samuelwilliams413/METR4901/Report/ReadMe.txt

A folder named \Build Photos is referenced in the report. It was too large for turn it in. The file can be found at https://drive.google.com/open?id=0B4WJuqQCXdjjd29NcDBHSWNPaW8

The file was also forwarded to my Supervisor Dr Paul Pounds
