samuelwilliams413/METR4901/Demo Poster/FUNC.pptx

Observe current state of pilot/desired state of suit

Measure position of limbs in relation to origin

Define Origin / Rotational Axis

Measure position of limbs in relation to fixed rotational axis on suit

Parse readings into useable data

Create fixed measurement point

Detect distance / proximity

Map from ADC readings to meters

Detect Signal

Remove Noise

Apply Sufficient Amplification

Read Signal

Determine action required

Derive required action of the suit from any given state

Develop control method based on kinematics of the suit

Tune PID Parameters

Derive Equations of Motion (EOM)

Derive Transfer function ( θ→τ )

Laplace Transform

Derive PID parameters

Achieve/approach the desired position of the suit

Observe and apply currently required change in commands

OUTSIDE OF SCOPE
Measure position of suit

OUTSIDE OF SCOPE
Regulate torque output of actuators

Observe current state of suit

Communicate Desired Action

Receive Messages

Transmit Messages

Read values into memory (DMA)

Parse Messages

Create Messages

Read values from memory (DMA)

Create Messaging Protocol

Establish DMA

Transmit Message over communications system

Measure suit interaction with environment (force)

Measure pilot interaction with suit (force)

Demonstrate functionality of subsystems

Demonstrate functionality of distance measurement (SS1)

Demonstrate functionality of force measurement (SS2)

Demonstrate functionality of control system (SS3)

Demonstrate functionality of communication (SS4)

Demonstrate force application trigger safety stop

Demonstrate system responding appropriately to stimulus

Demonstrate messages being transmitted over UART

Demonstrate system behaviour being adjusted via comms

Show actuator position adjusting due to distance measurement

Show sensor readings adjusting actuator over UART

Adjust actuator position in response to system command

Measure force applied at external contact points

Measure force applied at internal contact points

Parse readings into useable data

Create rigid contact points

Measure Force Applied

Create frame

Create Sensor Mount

Map from ADC readings to meters

Amplify Signal

Measure Force via Load Cell

SS1: Relative Position of Pilot

SS2: Force applied by & to Exoskeleton

SS3: Controls and Decision Making

SS4: Communications

Outside of Scope

SS5: Actuation Systems
