samuelwilliams413/METR4901/Demo Poster/Graphics.pptx

Pilot Foot

Maintain ∆F=0

Pilot Force

Suit Force

Ground

Forward Proximity

Pilot Thigh

x_(Forward)

x_(Rear)

Pilot Shin

Maintain
∆x=0
→∆θ=0

Rear Proximity
