samuelwilliams413/METR4901/Demo Poster/Signal_Data_Flow_Diagram.pptx

PXY = GPIO Port X Pin Y

Previous Controller

UART [Baud 9600]

UART [Baud 9600]

Next Controller

RX(PA3), TX(PA2)

UART [Baud 9600]

Messages [ASCII]

Messages [ASCII]

UART [Baud 9600]

RX(PA10), TX(PA9)

UART1

Messages [ASCII]

DMA

Control & Status

NUCLEO-F303K8 Controller Software

UART2

Memory

PA4..PA7

Proximity (P1..P4) 0-5V

LM358AD Op Amp x2

Signal (P1..P4) 0-5V

4x Vishay TRCT5000 IR Sensor

Messages [ASCII]

Proximity
(P1..P4)

Timer 3 Channel 1

50kHz

Load (Top, Bottom)

PA0, PA1

2x INA125PA
Instrumentation Amp

Load (T1..T4, B1..B4)

8x YZC-161B
50kg Load Cell

Control

PWM Interface

Digital Control

Voltage 50kHz

Servo

PB4

Load (Top, Bottom) 0-5V

Power 50kHz

Motor
