samuelwilliams413/METR4901/Demo Poster/Process Flow.pptx

Main

ADC A-F

Update Position & Load

Torque Data

Store Torque Messages

Start

Initialise

Delay to initialise values before movement

Transmit messages via DMA

UART Messages

Position
& Load Data

Store Angle Messages

t > 1000 ms

Yes

Calculate Control (Torque)

No
