samuelwilliams413/METR4901/Demo Poster/Text C2.docx

The process of developing the controls for the system was as follows: develop equations of motion (EOM) for the system, derive transfer functions (TF) from the EOM, perform Laplace transforms on the TF, and develop PID control for the system.

To begin the control theory the following assuming are foundational:

- Pilot is self-correcting and self-balancing;
- Pilot and suit are rigidly attached at the torso;
- Suit legs are capable of operating and moving independently;

Based on these assumptions it is possible to treat each leg as separate, and symmetrical but independent control problems. By adding the design constraint that all actuators and limbs shall lay on the same rotational axis, it is possible to treat each leg as a 3 DOF RR manipulator. The generalised equation relating the torque of the system it is resulting accelerations and velocities is given by kt:

τ=Mq+v+g

Where

- τ= vector of applied generalised forces
- M= manipulator mass matrix
- q= generalised accelerations of the system
- v= vector of centrifugal and coriolis forces
- g= vector of gravity forces

To find the PID control parameters for each joint

Develop Equations of Motion

The generalised equation relating the torque of the system it is resulting accelerations and velocities is given by kt:

τ=Mq+v+g

Where

M=m_1 J_(v1)^T J_(v1) +J_(ω1)^T I_1 J_(ω1) +m_2 J_(v2)^T J_(v2) +J_(ω2)^T I_2 J_(ω2) +m_3 J_(v3)^T J_(v3) +J_(ω3)^T I_3 J_(ω3)

J_(vi) = kt

J_(ωi) = kt

p_(c1,c2,c3) =[l_1 cos(θ_1 ), l_1 cos(θ_1 )+l_2 cos(θ_1 +θ_2 ), l_1 cos(θ_1 )+l_2 cos(θ_1 +θ_2 )+l_3 cos(θ_1 +θ_2 +θ_3 )l_1 sin(θ_1 ), l_1 sin(θ_1 )+l_2 sin(θ_1 +θ_2 ), l_1 sin(θ_1 )+l_2 sin(θ_1 +θ_2 )+l_3 sin(θ_1 +θ_2 +θ_3 )0, 0, 0]

v=Mq-1/2[q^T M_(q1) qq^T M_(q2) qq^T M_(q3) q]=[b_111 , b_122 , b_133 b_211 , b_222 , b_233 b_311 , b_322 , b_333 ][q_1^2 q_2^2 q_3^2 ]+[][, , ]

v(q,q)=C(q)[q^2 ]+B(q)[qq]

C(q)=[b_111 , b_122 b_211 , b_222 , ⋯, b_(1nn) ⋯, b_(2nn) ⋮, ⋮b_(n11) , b_(n22) , ⋮, ⋮⋯, b_(nnn) ]

B(q)=

Develop Transfer Function
