samuelwilliams413/METR4901/Matlab Docs/compile_all.docx

## Contents

function [H] = compile_all(DOF, A)

Degrees_Of_Freedom = DOF

Degree_To_Analyse = A

## Remember Everything Is In Radians

syms s

Transfer_Functions = collect(get_EOM(DOF),s)

H = get_TF(Transfer_Functions)

sys = H(A)

type = 'PID'

pidTuner(sys,type)

end

Published with MATLAB® R2017b (http://www.mathworks.com/products/matlab/)
