samuelwilliams413/METR4901/Demo Poster/ControlParameters.pptx

L_1

m_1

I_1

θ_1 ,θ_1 ,θ_1

l_1

θ_2 ,θ_2 ,θ_2

l_2

m_2

I_2

L_2

I_3

m_3

l_3

θ_3 ,θ_3 ,θ_3

L_3
