samuelwilliams413/METR4901/Documentation/Controls.pptx

Exoskeleton

R

R

R

R

R

R

Two 3 DOF
RRR Manipulators

## Slide 2

P1

L_1

θ_1

Thigh Link

θ_2

P2

L_2

Shin Link

Foot Link

L_3

θ_3

P3
