samuelwilliams413/METR4901/Documentation/_Hydra_Prime/MX Cube Config/NVIC Config A.PNG

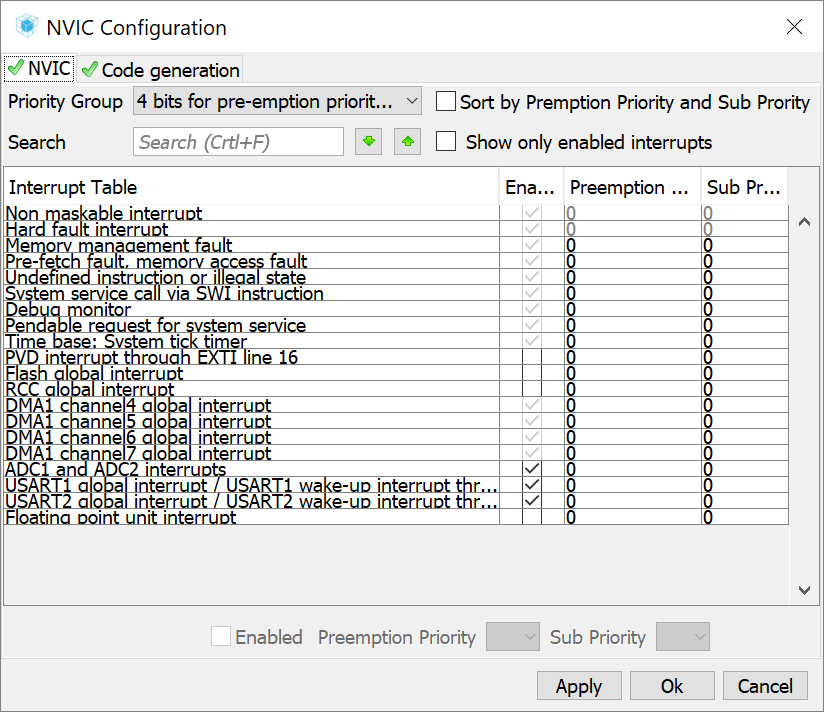
Documentation/_Hydra_Prime/MX Cube Config/NVIC Config A.PNG
