samuelwilliams413/METR4901/Documentation/_Hydra_Prime/MX Cube Config/Pin Outs.PNG

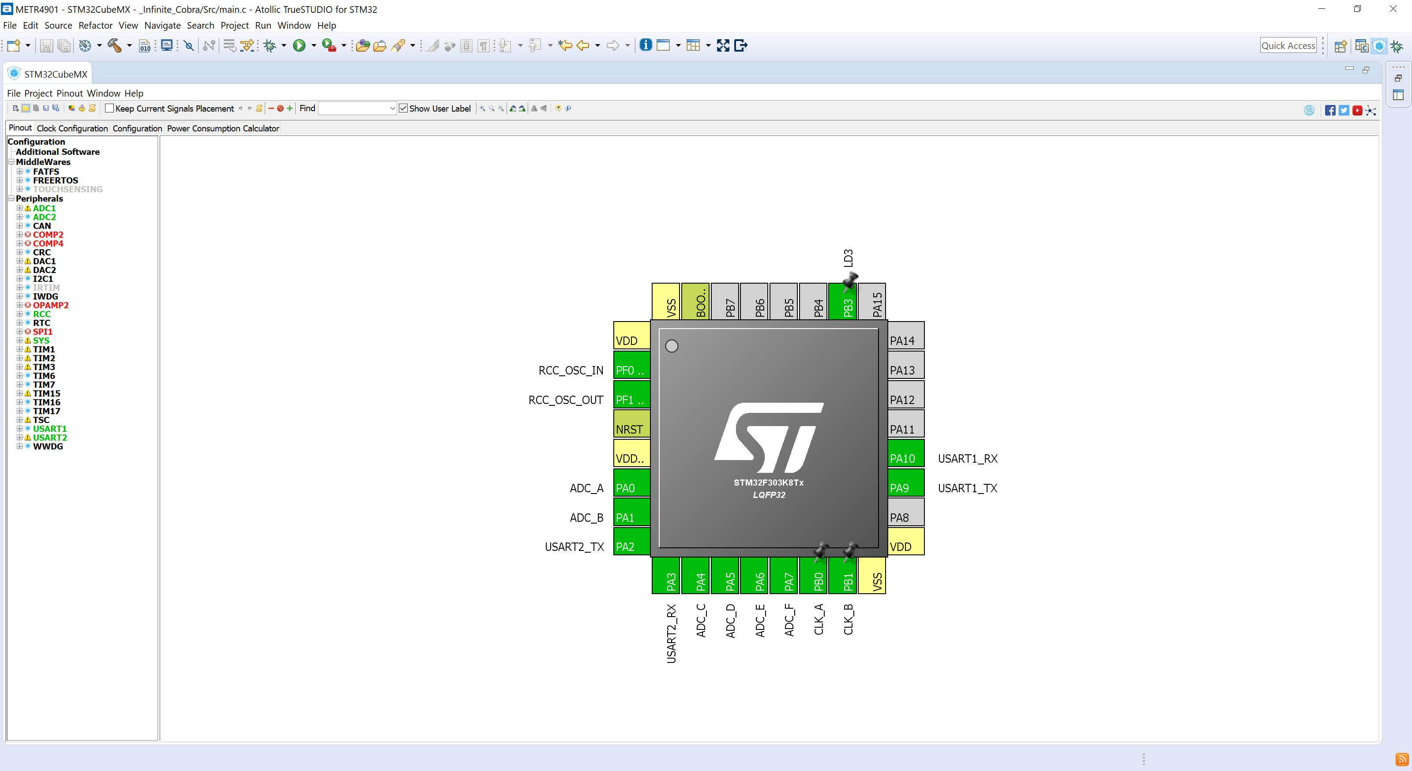
Documentation/_Hydra_Prime/MX Cube Config/Pin Outs.PNG
