samuelwilliams413/METR4901/Documentation/_Hydra_Prime/MX Cube Config/USART1 GPIO.PNG

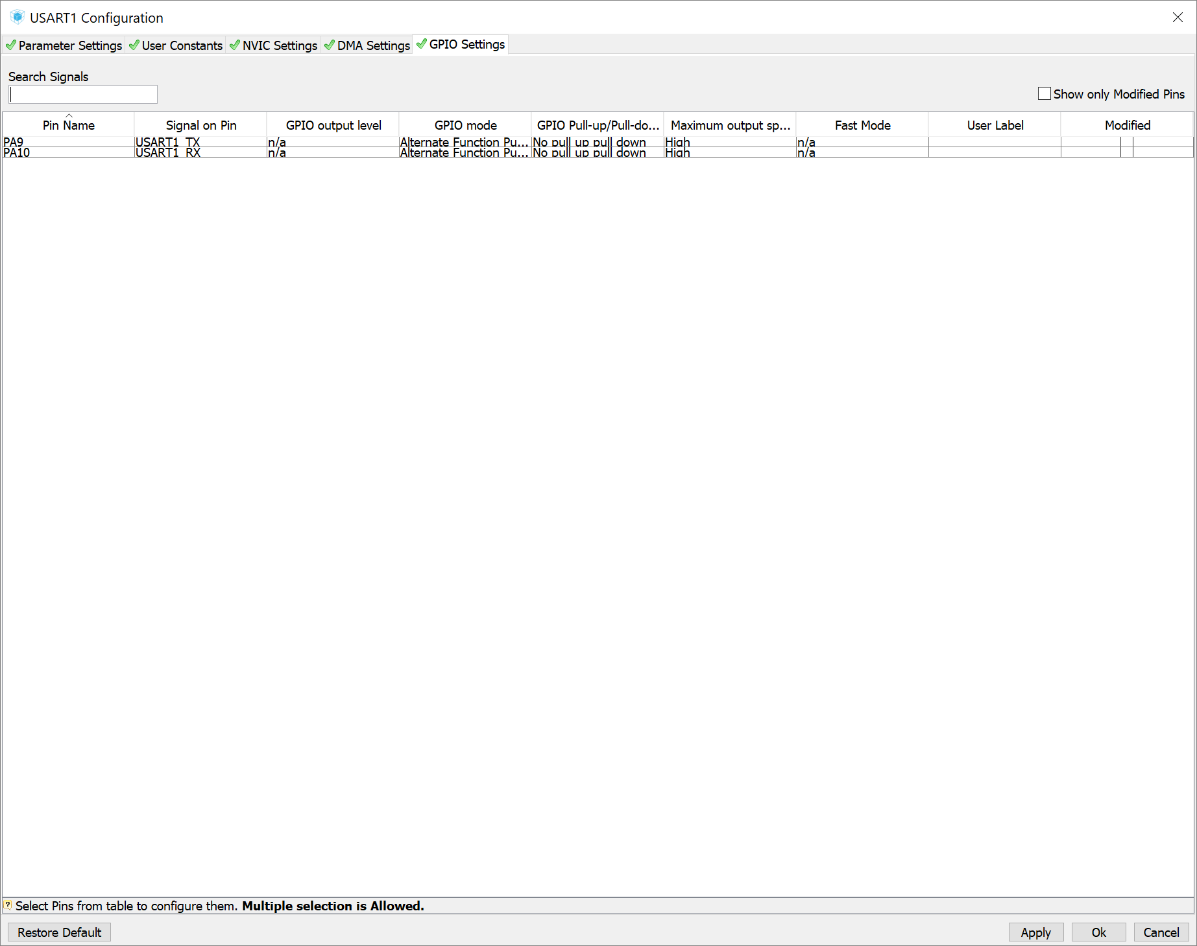
Documentation/_Hydra_Prime/MX Cube Config/USART1 GPIO.PNG
