samuelwilliams413/METR4901/Documentation/ADC Config.PNG

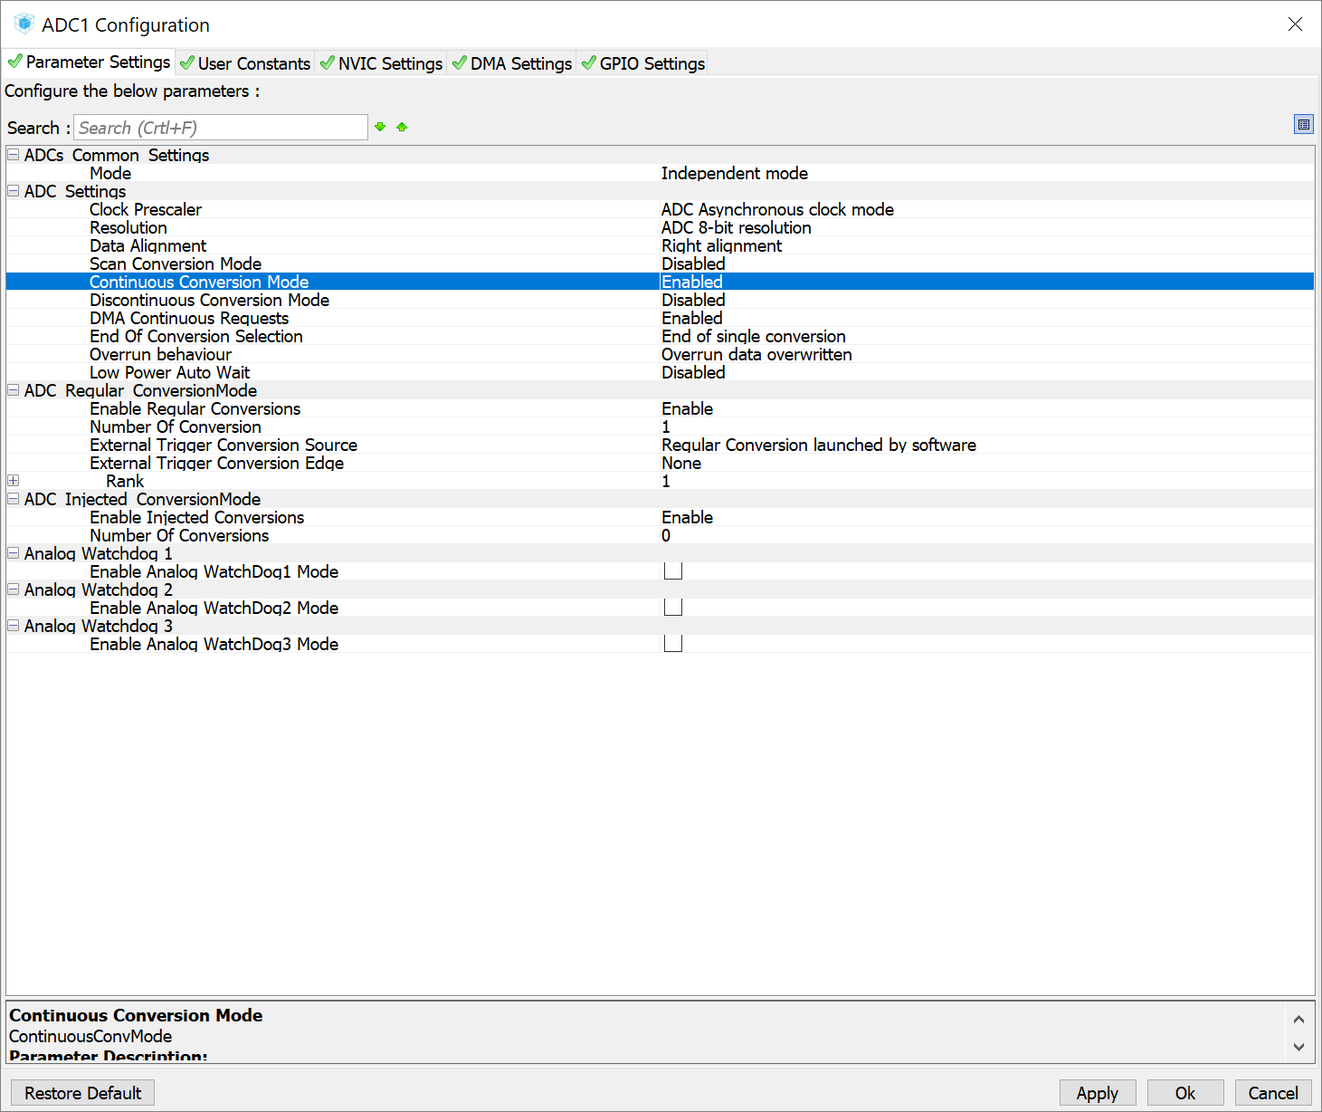
Documentation/ADC Config.PNG
