samuelwilliams413/METR4901/Documentation/ADC_2 Config part A.PNG

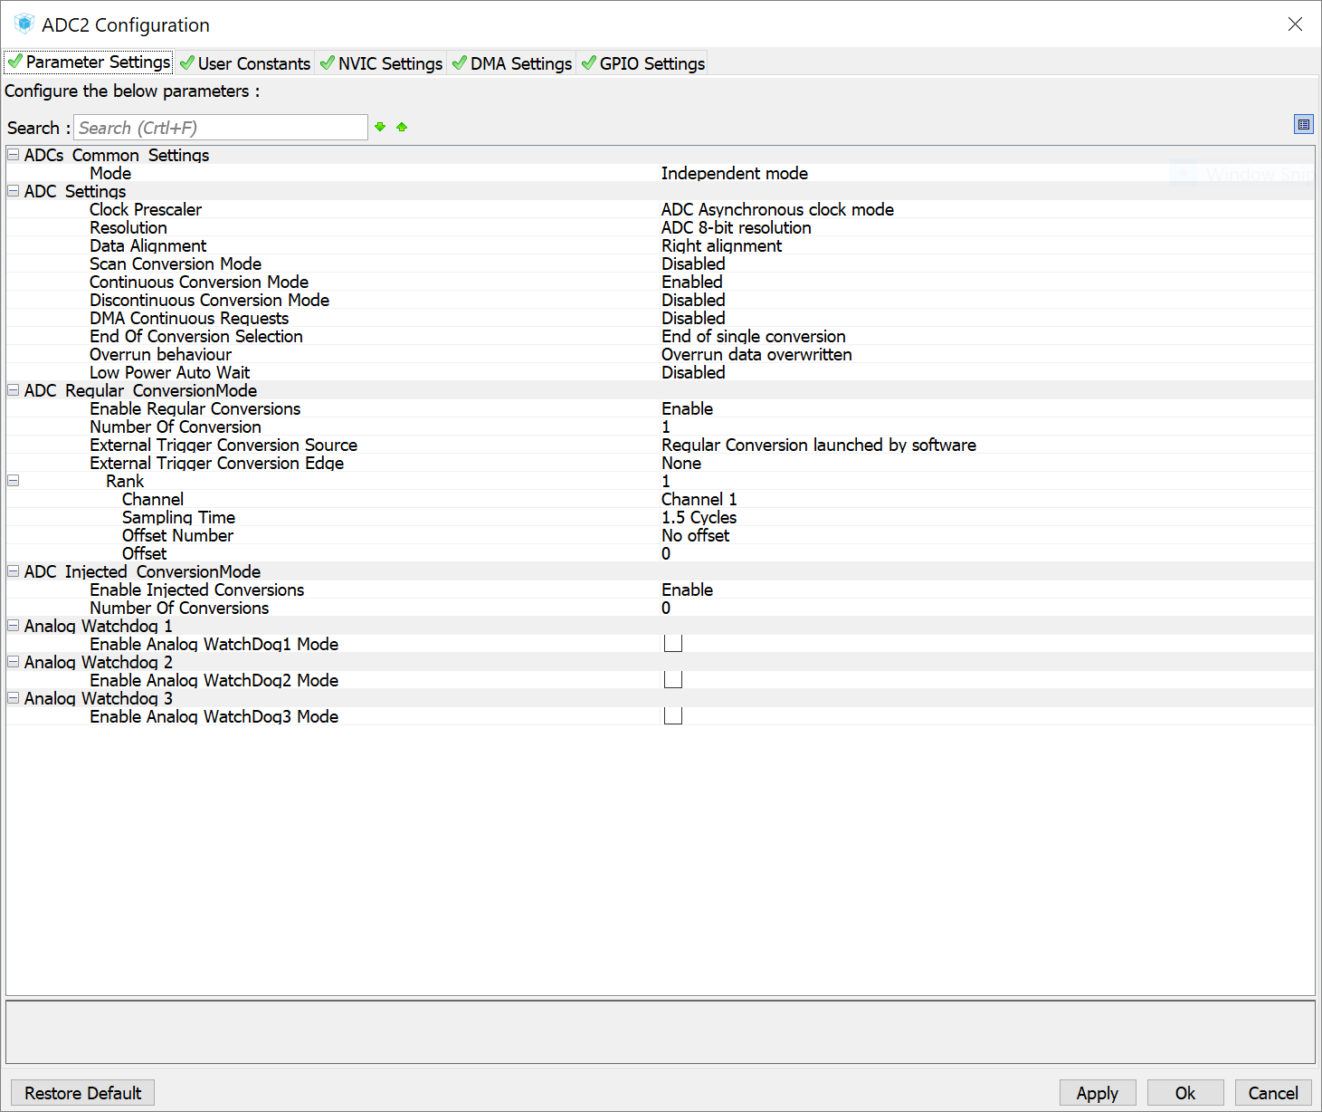
Documentation/ADC_2 Config part A.PNG
