samuelwilliams413/METR4901/Documentation/GPIO Pull down.PNG

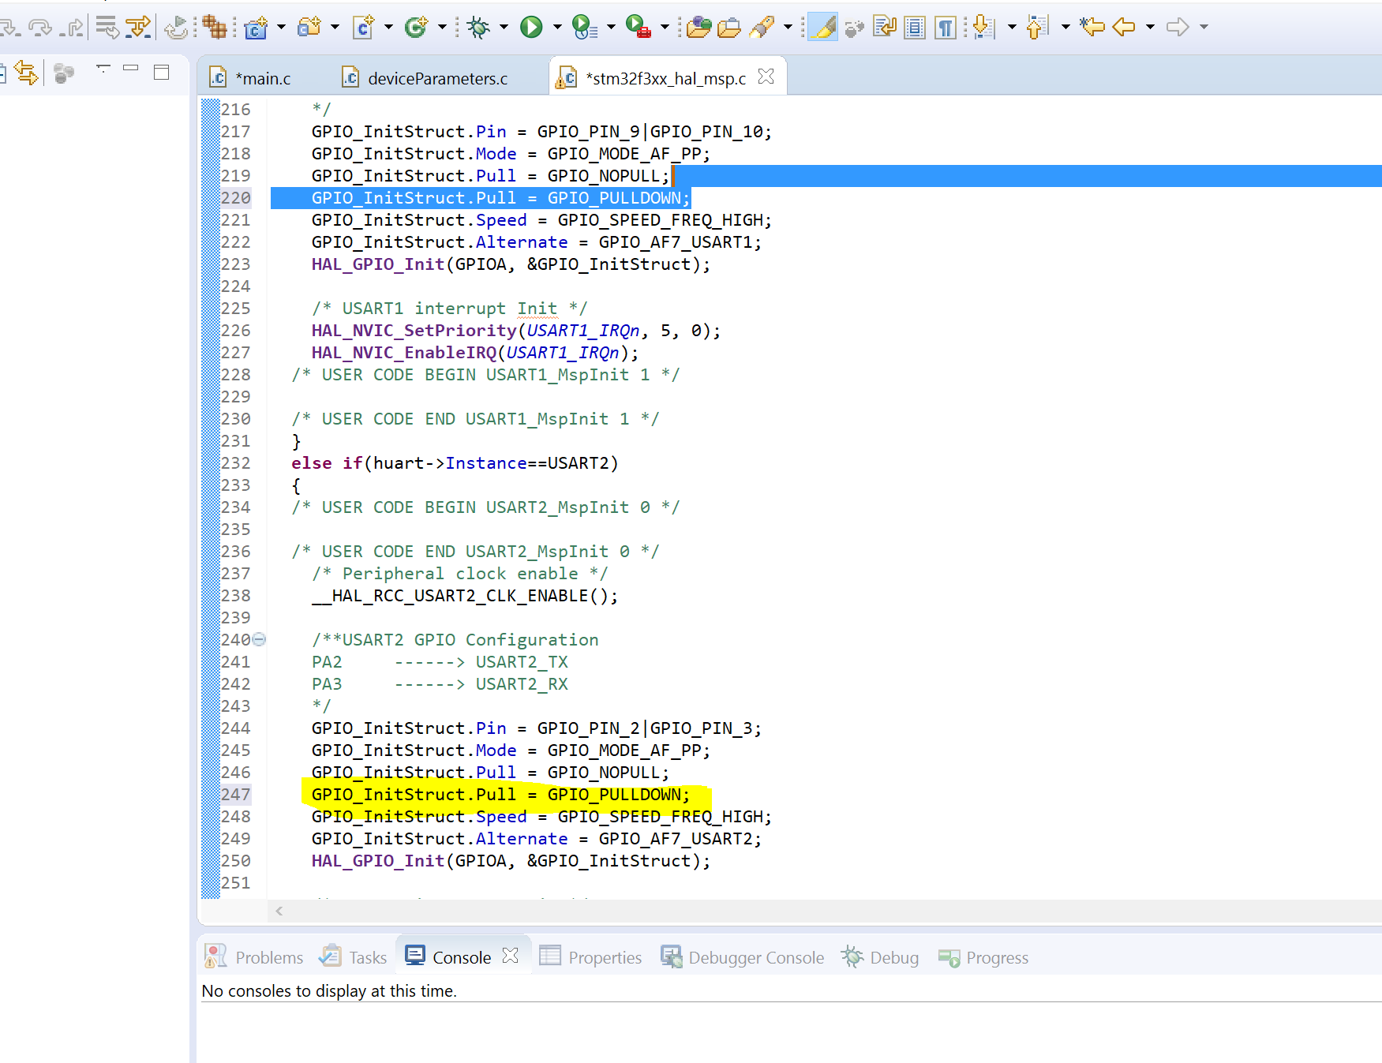
Documentation/GPIO Pull down.PNG
