samuelwilliams413/METR4901/Documentation/Putty Config.PNG

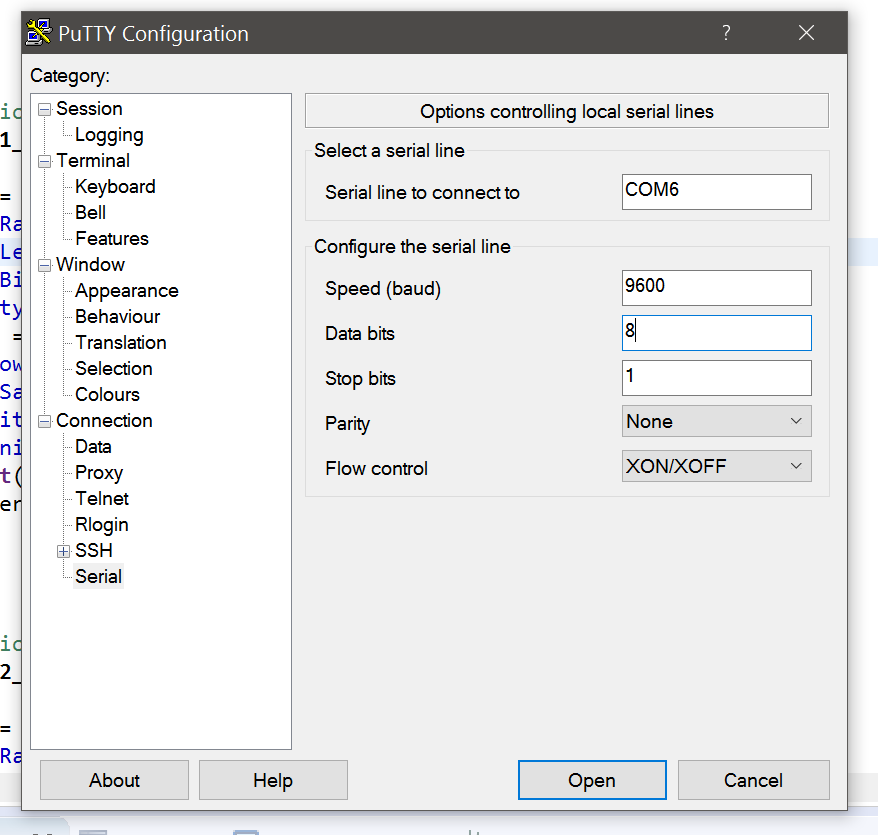
Documentation/Putty Config.PNG
