samuelwilliams413/METR4901/Documentation/UART1 Config.PNG

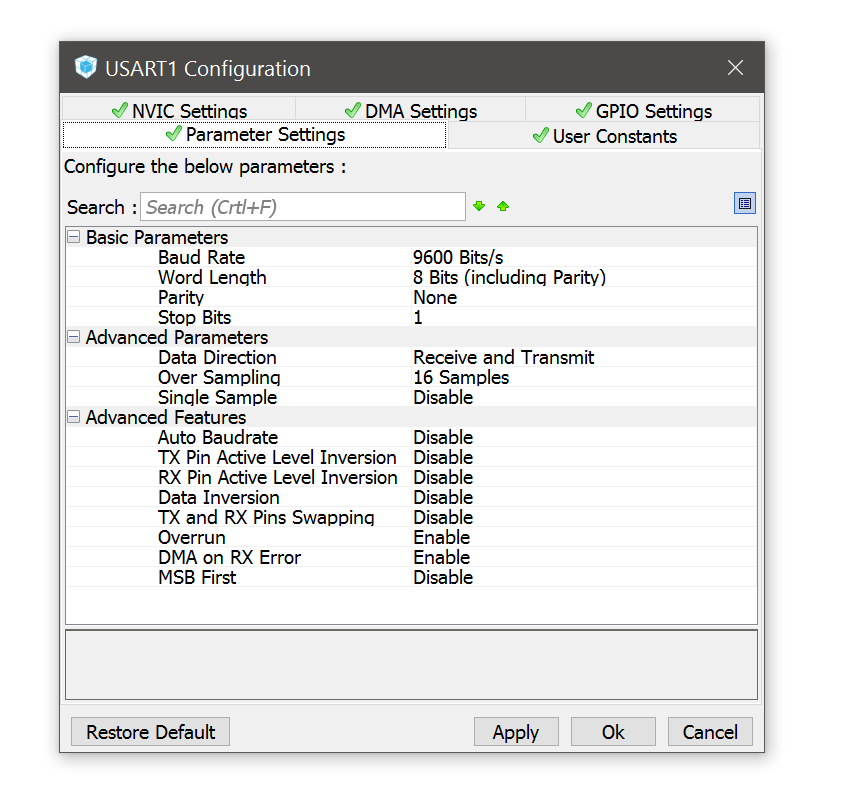
Documentation/UART1 Config.PNG
