samuelwilliams413/METR4901/BOM.xlsx

Sheet: BOM
BOM |  |  | TOTAL | 264.796 |  |  |  |  |  | Outstanding | 0 |  | 2018-04-20
Mount: | 7 |  |  |  |  |  |  |  |  |  |  |  | 7
Sensor: | 28 |  |  |  |  |  |  |  |  |  |  |  | 26
Part | QTY | Part Number | Cost | Total | Notes | RS Stock No. | Inventory | Safety | Picked | Remaining | Total | Remaining Inventory
Blue Led | 7 | Osram Opto CHIPLED 0603 470 nm Blue LED, 1608 (0603) SMD package | 0.404 | 2.828 | 10 Pack | 697-3617 | 3 |  | 7 | 0 | 0 | 0
Res 10k | 28 | Vishay CRCW Series Thick Film Surface Mount Fixed Resistor 0805 Case 10kΩ ±1% 0.125W ±100ppm/°C | 0.036 | 1.008 | 50 Pack | 679-0816 | 24 |  | 28 | 0 | 0 | 0
Res 220 | 28 | Vishay CRCW Series Thick Film Surface Mount Fixed Resistor 0805 Case 220Ω ±1% 0.125W ±100ppm/°C | 0.036 | 1.008 | 50 Pack | 679-1096 | 24 |  | 28 | 0 | 0 | 0
Res 1k | 7 | Vishay CRCW Series Thick Film Surface Mount Fixed Resistor 0805 Case 1kΩ ±1% 0.125W ±100ppm/°C | 0.036 | 0.252 | 50 Pack | 679-0982 | 43 |  | 7 | 0 | 0 | 36
Nucleo | 7 | STM32 Nucleo-32 development board | 16.73 | 117.11 | 0 | 0 | 1 |  | 7 | 0 | 0 | 0
Reflective IR Sensor | 28 | Vishay TCRT5000L, Through Hole Reflective Sensor, Transistor Output 2, Leaded package | 1.317 | 36.876 | 0 | 0 | 3 |  | 28 | 0 | 0 | 0
USB to Micro USB Cable (1.8m) | 7 | RS USB2.0 Cable, A-MicroB, M/M, 1.8m | 2.51 | 17.57 | 0 | 0 | 1 |  | 7 | 0 | 0 | 0
Ethernet Cable 1.5m | 7 | RJ45 YELLOW PATCH LEADS UTP | 2.83 | 19.81 | 0 | 0 | 1 |  | 7 | 0 | 0 | 0
PCB Header 36 Pin M | 0 | HARWIN M20, 2.54mm Pitch, 36 Way, 1 Row, Straight Pin Header, Through Hole | 1.32 | 0 | 0 | 547-3166 | 0 |  | 0 | 0 | 0 | 0
PCB Header 36 Pin M, Right Angle | 0 | HARWIN M20, 2.54mm Pitch, 36 Way, 1 Row, Right Angle Pin Header, Through Hole | 1.78 | 0 | 0 | 547-3217 | 0 |  | 0 | 0 | 0 | 0
PCB Header 45 Pin, Socket | 0 | Stelvio Kontek MODUCOM Series 2.54mm Pitch 45 Way 1 Row Straight PCB Socket, Through Hole, Solder Termination | 3.02 | 0 | 0 | 230-4893 | 0 |  | 0 | 0 | 0 | 0
Ethernet Header | 14 | RS Pro Cat5 8 Way Right Angle PCB Mount Unshielded RJ45 Connector Female | 1.8 | 25.2 | 0 | 8208299 | 2 |  | 14 | 0 | 0 | 0
Hose Clamp (16mm) | 0 | JCS Hi-Torque Steel Slotted Hex Hose Clip Bolt Drive, 9mm Band Width, 14mm - 16mm Inside Diameter | 0.541 | 0 | 10 Pack | 727-5936 | 0 |  | 0 | 0 | 0 | 0
Nylon Snap Grip | 0 | RS Pro Nylon Snap Grip, 4.2mm Band Width, 5.6mm - 6.5mm Inside Diameter | 0.562 | 0 | 10 Pack | 475-1415 | 0 |  | 0 | 0 | 0 | 0
KK 2 Way | 0 | Molex KK 254 6410, 2.54mm Pitch, 2 Way, 1 Row, Straight PCB Header, Through Hole | 0.221 | 0 | 10 Pack | 483-8461 | 0 |  | 0 | 0 | 0 | 0
KK 3 Way | 63 | Molex KK 254 6410, 2.54mm Pitch, 3 Way, 1 Row, Straight PCB Header, Through Hole | 0.432 | 27.216 | 10 Pack | 483-8477 | 0 |  | 63 | 0 | 0 | 0
KK 3 Way [Right] | 0 | Molex KK 254 7478, 2.54mm Pitch, 2 Way, 1 Row, Right Angle PCB Header, Through Hole | 1.438 | 0 | 5 Pack | 173-2922 | 0 |  | 0 | 0 | 0 | 0
KK 6 way | 0 | Molex KK 254 6410, 2.54mm Pitch, 6 Way, 1 Row, Straight PCB Header, Through Hole | 0.566 | 0 | 10 Pack | 483-8506 | 0 |  | 0 | 0 | 0 | 0
KK 8 way | 0 | Molex KK 254 6410, 2.54mm Pitch, 8 Way, 1 Row, Straight PCB Header, Through Hole | 0.896 | 0 | 10 Pack | 483-8528 | 0 |  | 0 | 0 | 0 | 0
KK 12 way | 14 | Molex KK 254 6410, 2.54mm Pitch, 12 Way, 1 Row, Straight PCB Header, Through Hole | 1.137 | 15.918 | 10 Pack | 483-8540 | 0 |  | 14 | 0 | 0 | 0
KK 3 Way [Con] | 0 | Molex KK 254 2695, 2.54mm Pitch, 3 Way, 1 Row Female Connector Housing | 0.147 | 0 | 10 Pack | 679-5375 | 0 |  | 0 | 0 | 0 | 0
KK 12 Way [Con] | 0 | Molex KK 254 2695, 2.54mm Pitch, 12 Way, 1 Row Female Connector Housing | 0.754 | 0 | 10 Pack | 679-5439 | 0 |  | 0 | 0 | 0 | 0
Crimp Terminal | 0 | Molex KK 4809 Crimp Terminal Contact, Female, 0.05mm² to 0.35mm², 30AWG to 22AWG, Tin Plating | 0.117 | 0 | 100 Pck | 467-598 | 0 |  | 0 | 0 | 0 | 0
0 | 0 | #N/A | 0 | 0 | #N/A | #N/A | 0 |  | 0 | 0 | 0 | 0

Sheet: Mount
Parts | QTY | Part Number | Cost | Total | Note | RS Stock No.
Nucleo | 1 | STM32 Nucleo-32 development board | 16.73 | 16.73 | 0 | 0
Res 1k | 1 | Vishay CRCW Series Thick Film Surface Mount Fixed Resistor 0805 Case 1kΩ ±1% 0.125W ±100ppm/°C | 0.036 | 0.036 | 50 Pack | 679-0982
PCB Header 36 Pin M |  | HARWIN M20, 2.54mm Pitch, 36 Way, 1 Row, Straight Pin Header, Through Hole | 1.32 | 0 | 0 | 547-3166
PCB Header 45 Pin, Socket |  | Stelvio Kontek MODUCOM Series 2.54mm Pitch 45 Way 1 Row Straight PCB Socket, Through Hole, Solder Termination | 3.02 | 0 | 0 | 230-4893
Ethernet Cable 1.5m | 1 | RJ45 YELLOW PATCH LEADS UTP | 2.83 | 2.83 | 0 | 0
Ethernet Header | 2 | RS Pro Cat5 8 Way Right Angle PCB Mount Unshielded RJ45 Connector Female | 1.8 | 3.6 | 0 | 331-6437
USB to Micro USB Cable (1.8m) | 1 | RS USB2.0 Cable, A-MicroB, M/M, 1.8m | 2.51 | 2.51 | 0 | 0
Blue Led | 1 | Osram Opto CHIPLED 0603 470 nm Blue LED, 1608 (0603) SMD package | 0.404 | 0.404 | 10 Pack | 697-3617
KK 12 way | 2 | Molex KK 254 6410, 2.54mm Pitch, 12 Way, 1 Row, Straight PCB Header, Through Hole | 1.137 | 2.274 | 10 Pack | 483-8540
KK 3 Way | 5 | Molex KK 254 6410, 2.54mm Pitch, 3 Way, 1 Row, Straight PCB Header, Through Hole | 0.432 | 2.16 | 10 Pack | 483-8477

Sheet: Sensor
Part | QTY | Part Number | Cost | Total | Notes | RS Stock No.
Res 220 | 1 | Vishay CRCW Series Thick Film Surface Mount Fixed Resistor 0805 Case 220Ω ±1% 0.125W ±100ppm/°C | 0.036 | 0.036 | 50 Pack | 679-1096
PCB Header 36 Pin M, Right Angle | 0 | HARWIN M20, 2.54mm Pitch, 36 Way, 1 Row, Right Angle Pin Header, Through Hole | 1.78 | 0 | 0 | 547-3217
Res 10k | 1 | Vishay CRCW Series Thick Film Surface Mount Fixed Resistor 0805 Case 10kΩ ±1% 0.125W ±100ppm/°C | 0.036 | 0.036 | 50 Pack | 679-0816
Reflective IR Sensor | 1 | Vishay TCRT5000L, Through Hole Reflective Sensor, Transistor Output 2, Leaded package | 1.317 | 1.317 | 0 | 0
KK 3 Way | 1 | Molex KK 254 6410, 2.54mm Pitch, 3 Way, 1 Row, Straight PCB Header, Through Hole | 0.432 | 0.432 | 10 Pack | 483-8477

Sheet: Data
Parts | Cost | Part Number | Note | RS Stock No. | Inventory
Blue Led | $0.404 | Osram Opto CHIPLED 0603 470 nm Blue LED, 1608 (0603) SMD package | 10 Pack | 697-3617 | 3
Res 10k | $0.036 | Vishay CRCW Series Thick Film Surface Mount Fixed Resistor 0805 Case 10kΩ ±1% 0.125W ±100ppm/°C | 50 Pack | 679-0816 | 24
Res 220 | $0.036 | Vishay CRCW Series Thick Film Surface Mount Fixed Resistor 0805 Case 220Ω ±1% 0.125W ±100ppm/°C | 50 Pack | 679-1096 | 24
Res 1k | $0.036 | Vishay CRCW Series Thick Film Surface Mount Fixed Resistor 0805 Case 1kΩ ±1% 0.125W ±100ppm/°C | 50 Pack | 679-0982 | 43
Nucleo | $16.730 | STM32 Nucleo-32 development board |  |  | 1
Reflective IR Sensor | $1.317 | Vishay TCRT5000L, Through Hole Reflective Sensor, Transistor Output 2, Leaded package |  |  | 3
USB to Micro USB Cable (1.8m) | $2.510 | RS USB2.0 Cable, A-MicroB, M/M, 1.8m |  |  | 1
Ethernet Cable 1.5m | $2.830 | RJ45 YELLOW PATCH LEADS UTP |  |  | 1
PCB Header 36 Pin M | $1.320 | HARWIN M20, 2.54mm Pitch, 36 Way, 1 Row, Straight Pin Header, Through Hole |  | 547-3166
PCB Header 36 Pin M, Right Angle | $1.780 | HARWIN M20, 2.54mm Pitch, 36 Way, 1 Row, Right Angle Pin Header, Through Hole |  | 547-3217
PCB Header 45 Pin, Socket | $3.020 | Stelvio Kontek MODUCOM Series 2.54mm Pitch 45 Way 1 Row Straight PCB Socket, Through Hole, Solder Termination |  | 230-4893
Ethernet Header | $1.800 | RS Pro Cat5 8 Way Right Angle PCB Mount Unshielded RJ45 Connector Female |  | 331-6437 | 2
Hose Clamp (16mm) | $0.541 | JCS Hi-Torque Steel Slotted Hex Hose Clip Bolt Drive, 9mm Band Width, 14mm - 16mm Inside Diameter | 10 Pack | 727-5936
Nylon Snap Grip | $0.562 | RS Pro Nylon Snap Grip, 4.2mm Band Width, 5.6mm - 6.5mm Inside Diameter | 10 Pack | 475-1415
KK 2 Way | $0.221 | Molex KK 254 6410, 2.54mm Pitch, 2 Way, 1 Row, Straight PCB Header, Through Hole | 10 Pack | 483-8461
KK 3 Way | $0.432 | Molex KK 254 6410, 2.54mm Pitch, 3 Way, 1 Row, Straight PCB Header, Through Hole | 10 Pack | 483-8477 |  | 5
KK 3 Way [Right] | $1.438 | Molex KK 254 7478, 2.54mm Pitch, 2 Way, 1 Row, Right Angle PCB Header, Through Hole | 5 Pack | 173-2922 |  | 4
KK 6 way | $0.566 | Molex KK 254 6410, 2.54mm Pitch, 6 Way, 1 Row, Straight PCB Header, Through Hole | 10 Pack | 483-8506
KK 8 way | $0.896 | Molex KK 254 6410, 2.54mm Pitch, 8 Way, 1 Row, Straight PCB Header, Through Hole | 10 Pack | 483-8528
KK 12 way | $1.137 | Molex KK 254 6410, 2.54mm Pitch, 12 Way, 1 Row, Straight PCB Header, Through Hole | 10 Pack | 483-8540 |  | 2
KK 3 Way [Con] | $0.147 | Molex KK 254 2695, 2.54mm Pitch, 3 Way, 1 Row Female Connector Housing | 10 Pack | 679-5375
KK 12 Way [Con] | $0.754 | Molex KK 254 2695, 2.54mm Pitch, 12 Way, 1 Row Female Connector Housing | 10 Pack | 679-5439
Crimp Terminal | 0.117 | Molex KK 4809 Crimp Terminal Contact, Female, 0.05mm² to 0.35mm², 30AWG to 22AWG, Tin Plating | 100 Pck | 467-598
