samuelwilliams413/METR4901/(list of files, cad)

Other CAD files:
Report/CAD Schematics/Inventor Files/Attachment_Double.ipt
Report/CAD Schematics/Inventor Files/Attachment_Single.ipt
Report/CAD Schematics/Inventor Files/Cable_Guide.ipt
Report/CAD Schematics/Inventor Files/Lower_Loadcell_Mount.ipt
Report/CAD Schematics/Inventor Files/Mount_Brace.ipt
Report/CAD Schematics/Inventor Files/Mount_Panel.ipt
Report/CAD Schematics/Inventor Files/SMW-43219667-METR4901.idw
Report/CAD Schematics/Inventor Files/SensorMount - B.ipt
Report/CAD Schematics/Inventor Files/Sensor_Mount.ipt
Report/CAD Schematics/Inventor Files/Upper_Loadcell_Mount.ipt
