samuelwilliams413/METR4901/Documentation/Load Cell Calibration.xlsx

Sheet: Sheet1 (2)
Load Cell Calibration |  |  | Load Cell Calibration
Weight | A (Bot) | B (Top) | Weight | A (Bot) | Weight | B (Top) | Weight | a1 | a2 | a3 | b1 | b2 | b3
0 | 3260 | 697 | 0 | 3113.333333 | 0 | 1500.333333 | 0 | 3140 | 3100 | 3100 | 1501 | 1500 | 1500
1000 | 2700 |  | 1 | 2522.666667 | 1000 | 1441 | 1000 | 2577 | 2495 | 2496 | 1443 | 1440 | 1440
1200 | 2575 | 625 | 1.2 | 1909.666667 | 2000 | 1386 | 2000 | 2003 | 1895 | 1831 | 1393 | 1388 | 1377
1450 | 2450 | 619 | 1.45
1700 | 2325 | 596 | 1.7
1950 | 2175 | 581 | 1.95
2200 | 2040 | 569 | 2.2
2450 | 1910 | 556 | 2.45
2700 | 1775 | 544 | 2.7
2950 | 1620 | 529 | 2.95
3200 | 1500 |  | 3.2
3450 | 1390 |  | 3.45
3700 | 1245 |  | 3.7
3950 | 1130 |  | 3.95
4200 | 1000 |  | 4.2
4450 | 875 |  | 4.45
4700 | 730 |  | 4.7
4950 | 620 |  | 4.95
5200 | 490 |  | 5.2
5450 | 380 |  | 5.45
5700 | 270 |  | 5.7
5950 | 230 |  | 5.95
6200 | 200 |  | 6.2
6450 | 190 |  | 6.45
6700 | 180 |  | 6.7
6950 | 170 |  | 6.95
5750 |  |  | 5.75
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
