samuelwilliams413/METR4901/Documentation/HX711 Problems/arduino boi.PNG

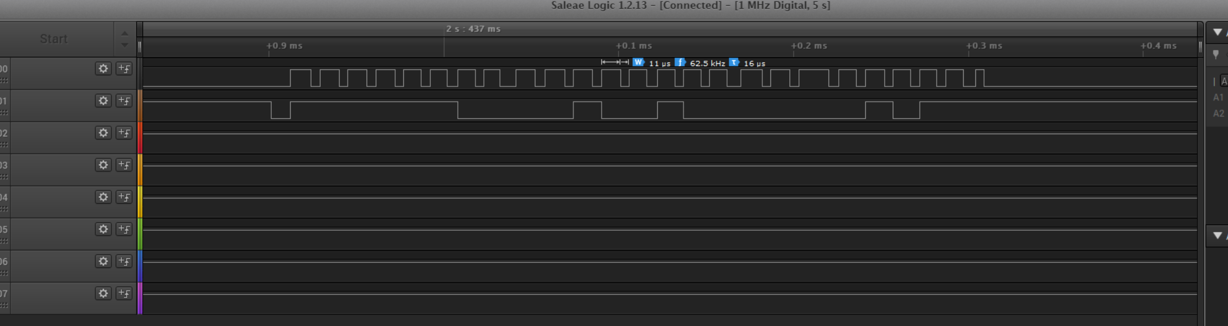
Documentation/HX711 Problems/arduino boi.PNG
