samuelwilliams413/METR4901/Documentation/HX711 Problems/microdelay.PNG

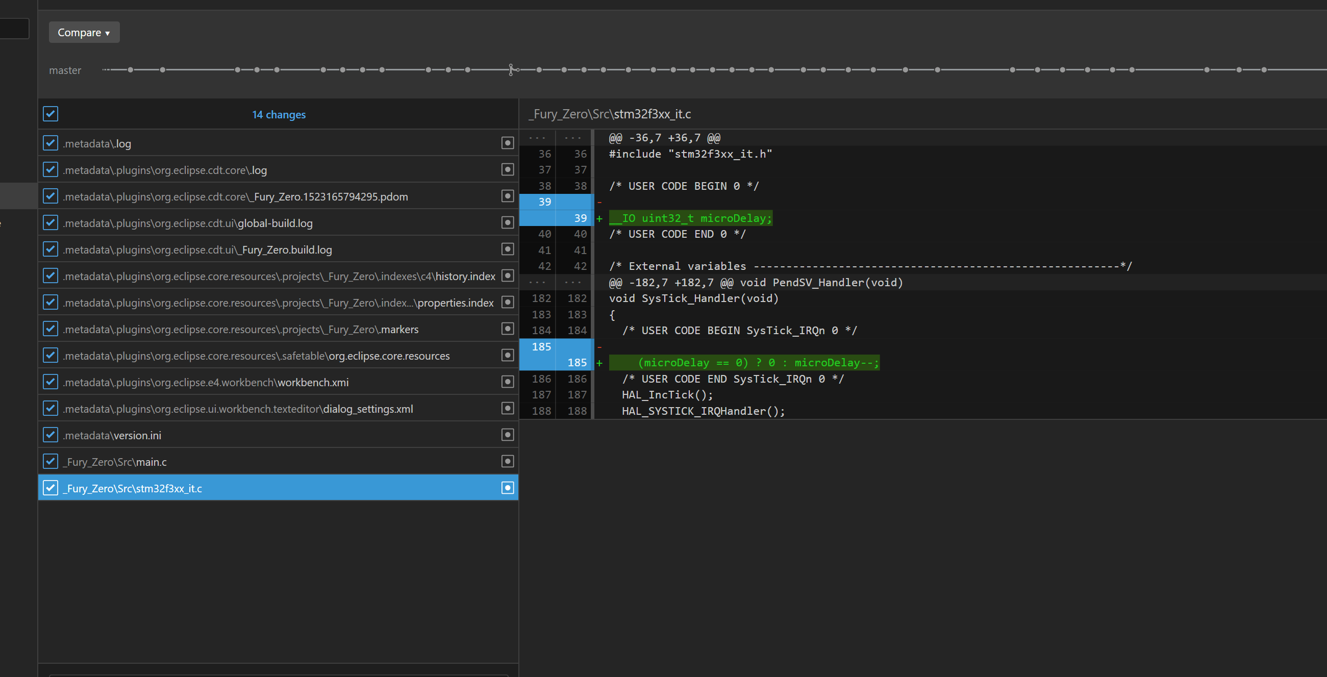
Documentation/HX711 Problems/microdelay.PNG
