samuelwilliams413/METR4901/Documentation/HX711 Problems/naughtySTMtoFAST.PNG

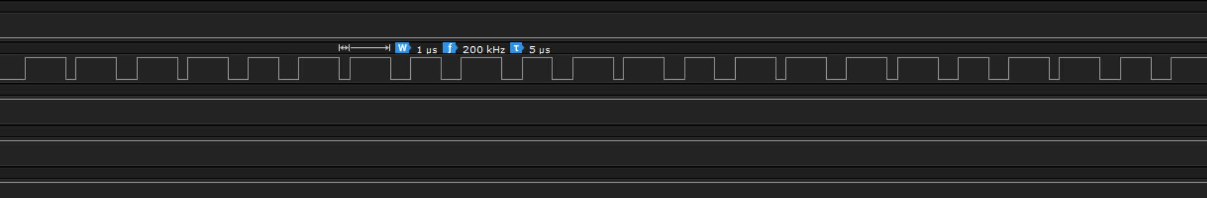
Documentation/HX711 Problems/naughtySTMtoFAST.PNG
