samuelwilliams413/METR4901/Demo Poster/Signal_Data_Flow_Diagram.pdf

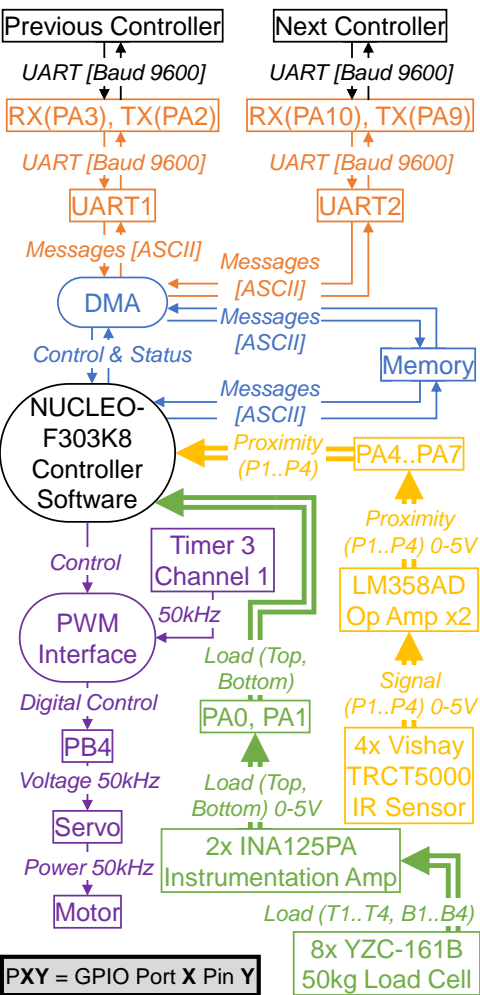
[picture p63: page 1]
2x INA125PA Instrumentation Amp; Memory; UART1; UART2; DMA; PWM Interface; Servo; NUCLEO- F303K8 Controller Software; 8x YZC-161B 50kg Load Cell; 4x Vishay TRCT5000 IR Sensor; LM358AD Op Amp x2; Proximity (P1..P4) 0-5V; Signal (P1..P4) 0-5V; Proximity (P1..P4); UART [Baud 9600]; Messages [ASCII]; Control & Status; Timer 3 Channel 1 Control; Digital Control; Voltage 50kHz; Motor; Power 50kHz; 50kHz; Load (Top, Bottom); Load (Top, Bottom) 0-5V; Load (T1..T4, B1..B4); Previous Controller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

PXY = GPIO Port X Pin Y
