samuelwilliams413/METR4901/Documentation/STM32 Nuclero-32 Board User Manual [en.DM00231744] - Electrical Schematics.pdf

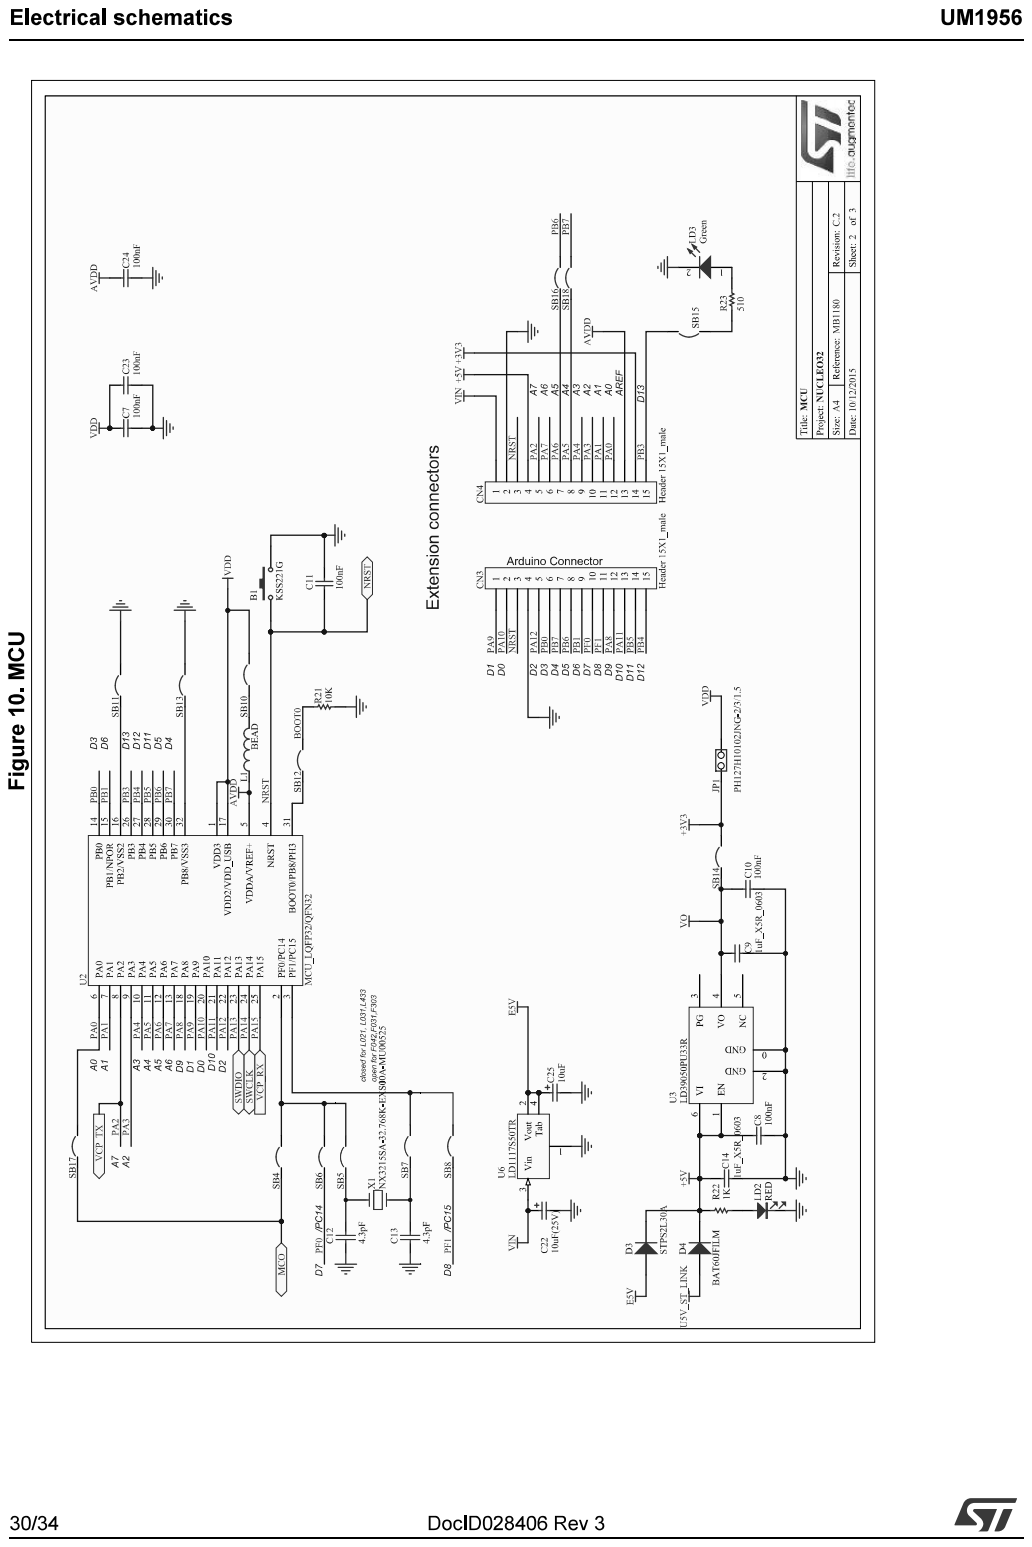
[picture p64: page 1]
