samuelwilliams413/METR4901/Documentation/Arm Cortex STM32F303x8 [en.DM00092070] - Alternate Functions.pdf

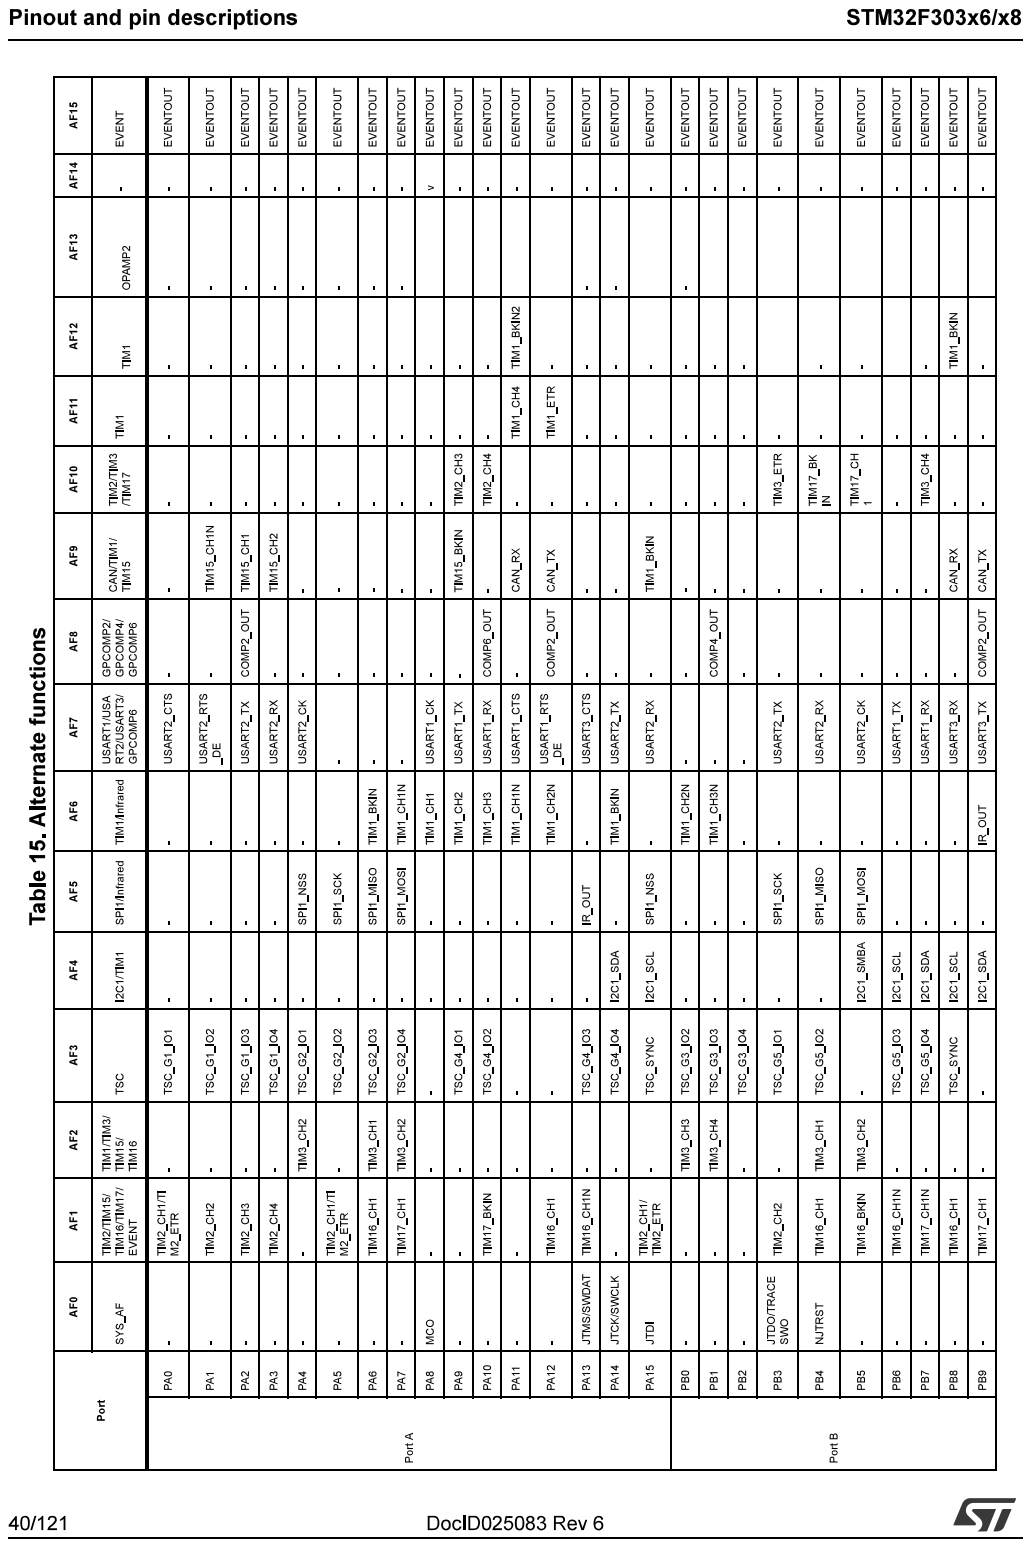
[picture p65: page 1]

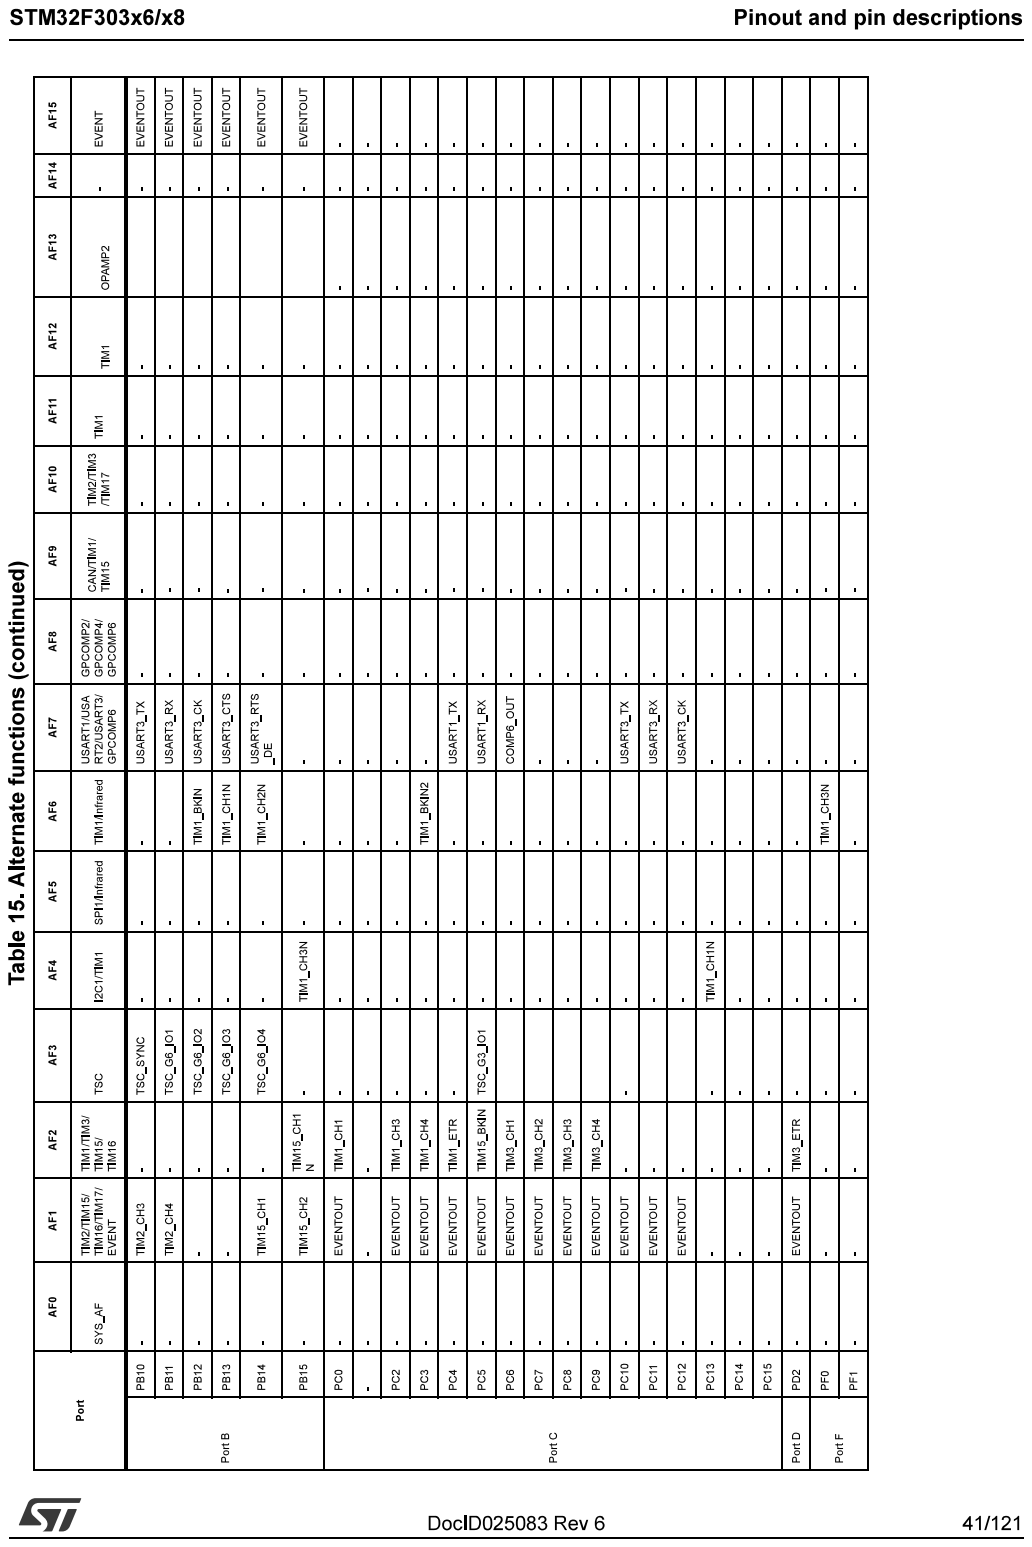
[picture p66: page 2]
