samuelwilliams413/METR4901/LT Spice Model/SallenKeyBandPassFIlter (Two Op Amp).asc

C1: cap; {C1}
C2: cap; {C2}
C3: cap; {C3}
C4: cap; {C4}
R1: res; {R1}
R2: res; {R2}
R3: res; {R3}
R4: res; {R4}
U1: opamp2; TL072
U3: opamp2; TL072
V1: voltage; 12
V2: voltage; -12
V3: voltage; 1; AC 1.0
Named nets: 0, +12V, -12V, V_output, V_sensor
.lib opamp.sub
70kHz Sallenkey Cascading Bandpass Filter
;dc V3 -0.5 0.5 0.01
.ac dec 1000 7k 700k
.inc C:\\Users\\Samuel\\Documents\\LTspiceXVII\\lib\\TL072.txt
.param R1=32.14286k R2=16.07143 R3=22k R4=22k
.param C1=100p C2=100p C3=100p C4=100p
