samuelwilliams413/METR4901/LT Spice Model/SallenKeyLowPassFIlter.asc

C1: cap; {C1}
C2: cap; {C2}
R1: res; {R1}
R2: res; {R2}
U3: opamp2; TL072
V1: voltage; 12
V2: voltage; -12
V3: voltage; 1; AC 1.0
Named nets: 0, +12V, -12V, V_output, V_sensor
.lib opamp.sub
70kHz Sallenkey Low Pass Filter
;dc V3 -0.5 0.5 0.01
.ac dec 1000 7k 900k
.inc C:\\Users\\Samuel\\Documents\\LTspiceXVII\\lib\\TL072.txt
.param R1=22k R2=22k R3=0 R4=0
.param C1=100p C2=100p
