samuelwilliams413/METR4901/(list of files, drawings)

Other design files:
Auxiliary/7Robot.SchLib
Auxiliary/Con USB.PcbLib
Auxiliary/EAIT EEL EBESS Libs/KBpcb01.PCBLIB
Auxiliary/EAIT EEL EBESS Libs/KBpcb02.PCBLIB
Auxiliary/EAIT EEL EBESS Libs/KBpcb03.PCBLIB
Auxiliary/EAIT EEL EBESS Libs/KBpcb04.PCBLIB
Auxiliary/EAIT EEL EBESS Libs/KBpcb05.PCBLIB
Auxiliary/EAIT EEL EBESS Libs/KBpcb06.PCBLIB
Auxiliary/EAIT EEL EBESS Libs/KBpcb07.PCBLIB
Auxiliary/EAIT EEL EBESS Libs/KBsch01.SCHLIB
Auxiliary/EAIT EEL EBESS Libs/KBsch02.SCHLIB
Auxiliary/en.nucleo-32pins_sch/MB1180.PcbDoc
Auxiliary/en.nucleo-32pins_sch/MB1180.PcbLib
Auxiliary/en.nucleo-32pins_sch/MB1180.PrjPCB
Auxiliary/en.nucleo-32pins_sch/MB1180.SchDoc
Auxiliary/en.nucleo-32pins_sch/MB1180.SCHLIB
Auxiliary/en.nucleo-32pins_sch/MCU_32.SchDoc
Auxiliary/en.nucleo-32pins_sch/ST_LINK_V2-1.SCHDOC
Auxiliary/Lib_NetTieLib/NetTieLibSampleBoard/NetTieLibSampleBoard.PrjPcb
Auxiliary/Lib_NetTieLib/NetTieLibSampleBoard/PCB/NetTieLibSample.PcbDoc
Auxiliary/Lib_NetTieLib/NetTieLibSampleBoard/Source/NetTieLibSample.SchDoc
Auxiliary/Lib_NetTieLib/NetTieLibSource/NetTie.PcbLib
Auxiliary/Lib_NetTieLib/NetTieLibSource/NetTie.SchLib
Auxiliary/Libs_CAndreatta/Libs_CAndreatta_pcblib/pcblib/2x22-M90_2.54.PcbLib
Auxiliary/Libs_CAndreatta/Libs_CAndreatta_pcblib/pcblib/0204_MELF.PcbLib
Auxiliary/Libs_CAndreatta/Libs_CAndreatta_pcblib/pcblib/0207_MELF.PcbLib
Auxiliary/Libs_CAndreatta/Libs_CAndreatta_pcblib/pcblib/0603_C.PcbLib
Auxiliary/Libs_CAndreatta/Libs_CAndreatta_pcblib/pcblib/0603_L.PcbLib
Auxiliary/Libs_CAndreatta/Libs_CAndreatta_pcblib/pcblib/0603_R.PcbLib
Auxiliary/Libs_CAndreatta/Libs_CAndreatta_pcblib/pcblib/0805_C2.PcbLib
Auxiliary/Libs_CAndreatta/Libs_CAndreatta_pcblib/pcblib/0805_C.PcbLib
Auxiliary/Libs_CAndreatta/Libs_CAndreatta_pcblib/pcblib/0805_R.PcbLib
Auxiliary/Libs_CAndreatta/Libs_CAndreatta_pcblib/pcblib/1206_C2.PcbLib
Auxiliary/Libs_CAndreatta/Libs_CAndreatta_pcblib/pcblib/1206_C.PcbLib
Auxiliary/Libs_CAndreatta/Libs_CAndreatta_pcblib/pcblib/1206_MELF.PcbLib
Auxiliary/Libs_CAndreatta/Libs_CAndreatta_pcblib/pcblib/1206_R.PcbLib
Auxiliary/Libs_CAndreatta/Libs_CAndreatta_pcblib/pcblib/1210_C.PcbLib
Auxiliary/Libs_CAndreatta/Libs_CAndreatta_pcblib/pcblib/1210_R.PcbLib
Auxiliary/Libs_CAndreatta/Libs_CAndreatta_pcblib/pcblib/1210_V.PcbLib
Auxiliary/Libs_CAndreatta/Libs_CAndreatta_pcblib/pcblib/1806.PcbLib
Auxiliary/Libs_CAndreatta/Libs_CAndreatta_pcblib/pcblib/1808_C.PcbLib
Auxiliary/Libs_CAndreatta/Libs_CAndreatta_pcblib/pcblib/1808_R.PcbLib
Auxiliary/Libs_CAndreatta/Libs_CAndreatta_pcblib/pcblib/1812.PcbLib
Auxiliary/Libs_CAndreatta/Libs_CAndreatta_pcblib/pcblib/1812_C2.PcbLib
Auxiliary/Libs_CAndreatta/Libs_CAndreatta_pcblib/pcblib/1812_C3.PcbLib
Auxiliary/Libs_CAndreatta/Libs_CAndreatta_pcblib/pcblib/1812_C.PcbLib
Auxiliary/Libs_CAndreatta/Libs_CAndreatta_pcblib/pcblib/1812_R.PcbLib
Auxiliary/Libs_CAndreatta/Libs_CAndreatta_pcblib/pcblib/2220_V.PcbLib
Auxiliary/Libs_CAndreatta/Libs_CAndreatta_pcblib/pcblib/2512_R.PcbLib
Auxiliary/Libs_CAndreatta/Libs_CAndreatta_pcblib/pcblib/2818.PcbLib
Auxiliary/Libs_CAndreatta/Libs_CAndreatta_pcblib/pcblib/4527.PcbLib
Auxiliary/Libs_CAndreatta/Libs_CAndreatta_pcblib/pcblib/5078R-100.PcbLib
Auxiliary/Libs_CAndreatta/Libs_CAndreatta_pcblib/pcblib/5078R-100_180.PcbLib
Auxiliary/Libs_CAndreatta/Libs_CAndreatta_pcblib/pcblib/B2B-EH-A.PcbLib
Auxiliary/Libs_CAndreatta/Libs_CAndreatta_pcblib/pcblib/B2B-ZR.PcbLib
Auxiliary/Libs_CAndreatta/Libs_CAndreatta_pcblib/pcblib/B3B-EH-A.PcbLib
Auxiliary/Libs_CAndreatta/Libs_CAndreatta_pcblib/pcblib/B4B-EH-A.PcbLib
Auxiliary/Libs_CAndreatta/Libs_CAndreatta_pcblib/pcblib/B6B-EH-A.PcbLib
Auxiliary/Libs_CAndreatta/Libs_CAndreatta_pcblib/pcblib/B6B-PH-K-S.PcbLib
Auxiliary/Libs_CAndreatta/Libs_CAndreatta_pcblib/pcblib/B8B-PH-K-S.PcbLib
Auxiliary/Libs_CAndreatta/Libs_CAndreatta_pcblib/pcblib/B10B-EH-A.PcbLib
Auxiliary/Libs_CAndreatta/Libs_CAndreatta_pcblib/pcblib/B12B-ZR.PcbLib
Auxiliary/Libs_CAndreatta/Libs_CAndreatta_pcblib/pcblib/BNX02.PcbLib
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
