samuelwilliams413/METR4901/Auxiliary/SparkFun Load Sensor Combinator v11/SparkFun Load Sensor Combinator v11.brd

## EAGLE design Auxiliary/SparkFun Load Sensor Combinator v11/SparkFun Load Sensor Combinator v11.brd (2018-04-09, last stored version)

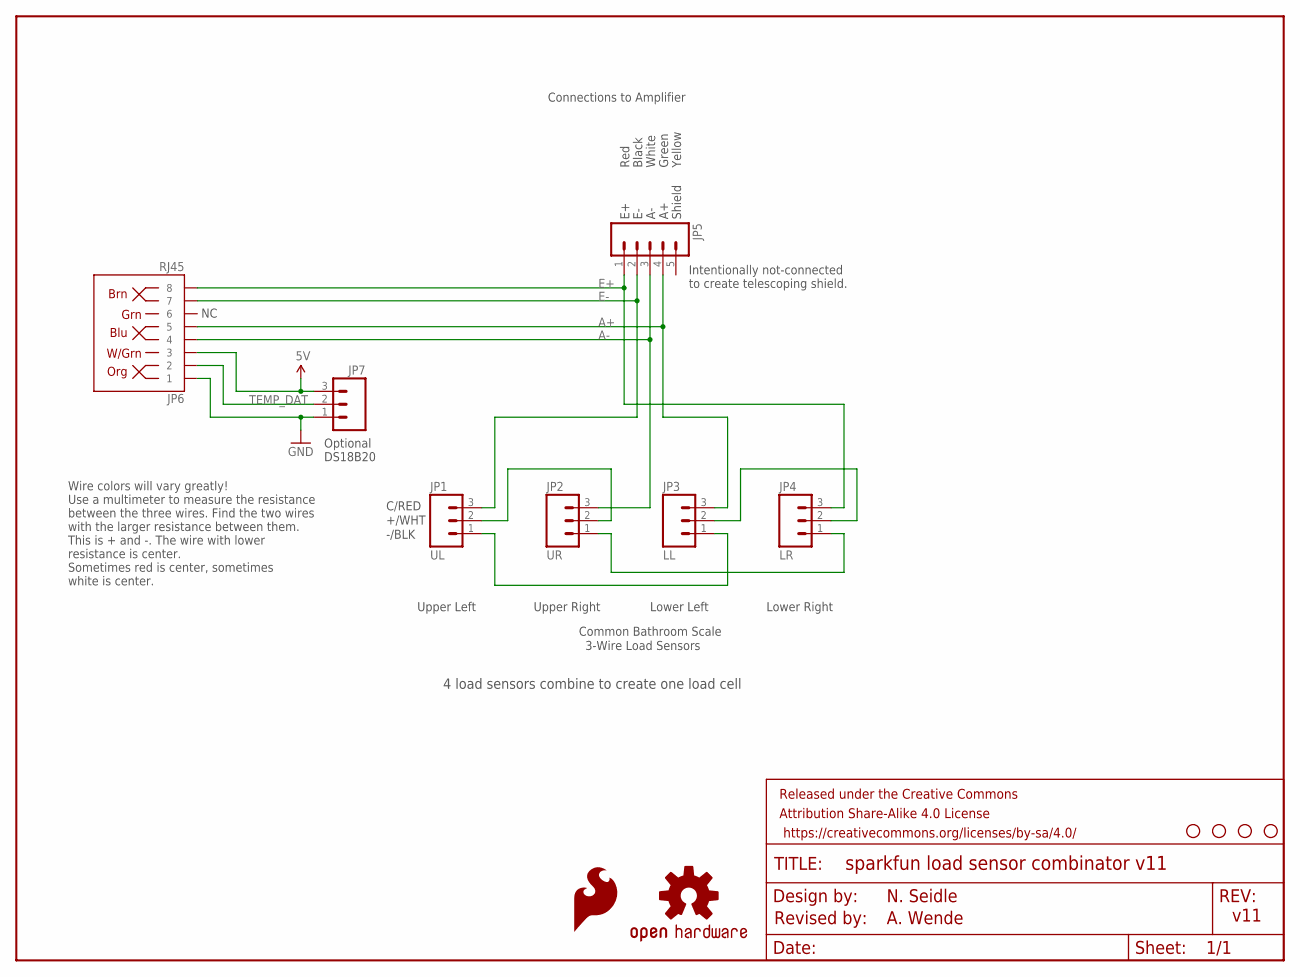
[picture p70: schematic SparkFun Load Sensor Combinator v11.sch]

Parts:
FRAME1: FRAME-LETTER; CREATIVE_COMMONS
JP1: UL; 1X03
JP2: UR; 1X03
JP3: LL; 1X03
JP4: LR; 1X03
JP5: M05PTH; 1X05
JP6: RJ45; RJ45-8
JP7: M03PTH; 1X03
LOGO3: SFE_LOGO_FLAME.1_INCH; SFE_LOGO_FLAME_.1
STANDOFF1, STANDOFF2, STANDOFF3, STANDOFF4: STAND-OFF
U$7: OSHW-LOGOS; OSHW-LOGO-S

Connections:
5V: JP6.3, JP7.3
A+: JP3.3, JP5.4, JP6.5
A-: JP2.3, JP5.3, JP6.4
E+: JP4.3, JP5.1, JP6.8
E-: JP1.3, JP5.2, JP6.7
GND: JP6.1, JP7.1
unnamed: JP2.1, JP4.1
unnamed: JP1.1, JP3.1
unnamed: JP3.2, JP4.2
unnamed: JP1.2, JP2.2
TEMP_DAT: JP6.2, JP7.2

Notes on the sheet:
Red
Black
White
Green
Lower Right
Upper Right
Lower Left
Upper Left
3-Wire Load Sensors
Common Bathroom Scale
Connections to Amplifier
-/BLK
+/WHT
C/RED
4 load sensors combine to create one load cell
Shield
Yellow
Intentionally not-connected to create telescoping shield.
Optional DS18B20
N. Seidle
v11
Revised by:
A. Wende
Wire colors will vary greatly\! Use a multimeter to measure the resistance between the three wires. Find the two wires with the larger resistance between them. This is + and -. The wire with lower resistance is center. Sometimes red is center, sometimes white is center.

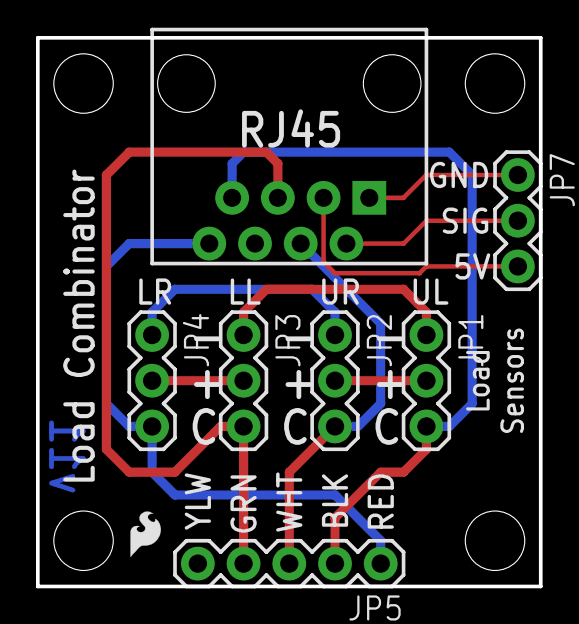
[picture p71: board SparkFun Load Sensor Combinator v11.brd from above]

Board: 2 copper layers, 27.9 x 30.5 mm, 14 parts (1 on the bottom side), 11 nets.
