samuelwilliams413/METR4901/_Infinite_Cobra/_Infinite_Cobra.ioc

Mcu.UserName=STM32F303K8Tx
PA0.GPIO_Label=ADC_A
PA0.Signal=ADC1_IN1
PA1.GPIO_Label=ADC_B
PA1.Signal=ADC1_IN2
PA10.Signal=USART1_RX
PA2.Signal=USART2_TX
PA3.Signal=USART2_RX
PA4.GPIO_Label=ADC_C
PA4.Signal=ADC2_IN1
PA5.GPIO_Label=ADC_D
PA5.Signal=ADC2_IN2
PA6.GPIO_Label=ADC_E
PA6.Signal=ADC2_IN3
PA7.GPIO_Label=ADC_F
PA7.Signal=ADC2_IN4
PA9.Signal=USART1_TX
PB0.GPIO_Label=CLK_A
PB0.Signal=GPIO_Output
PB1.GPIO_Label=DAT_B
PB1.Signal=GPIO_Input
PB3.GPIO_Label=LD3
PB3.Signal=GPIO_Output
PB6.GPIO_Label=CLK_B
PB6.Signal=GPIO_Output
PB7.GPIO_Label=DAT_A
PB7.Signal=GPIO_Input
