samuelwilliams413/METR4901/Arduino/Analogue Read/ana_read/ana_read.ino

int analogPin = 3;     // potentiometer wiper (middle terminal) connected to analog pin 3
                       // outside leads to ground and +5V
int val = 0;           // variable to store the value read

void setup()
{
  Serial.begin(9600);              //  setup serial
}

void loop()
{
  val = analogRead(analogPin);     // read the input pin
  Serial.println(val);             // debug value
}
