samuelwilliams413/METR4901/(commit log)

2018-02-08 Building Project, Git Ignore Updated
    [METR4901 Run.cfg]
2018-02-08 UART Tasks Prototyped
2018-02-09 UART2 Not performing Correctly
    [METR4901.ioc]
2018-02-09 UART 1 and 2 Working
2018-02-09 UART RX and TX working
    Need to store RX in buffer before printing, too much input can cause it
    to interupt itself
    [METR4901.ioc]
2018-02-20 Both UART are working
    Going to add a larger secondary queue to handle incoming messages to
    begin implimenting the connnection to message parsing functions
2018-02-21 Memory Overflow
    -Can't make Queues too large, this might be a problem. Fuark
    [METR4901.ioc]
2018-03-05 Setting up for inverse and transform
    [METR4901 Run.cfg]
2018-03-26 rx tx problems persist
    [myPID.c]
2018-04-04 _Cold_Hellion TX by DMA
2018-04-04 _Cold_Hellion DMA RX (from FTDI and HC-05 works)
    It seems that spending $87 on a different development board is the best
    way to solve problems with the current on.... grrrrr
2018-04-07 Stopped Printing for some reason.
2018-04-07 Trying to add ADC
2018-04-07 ADC kills UART, not sure why
2018-04-08 TX on a linear buffer is working great
    [METR4901 Run.cfg]
2018-04-08 ADC causes a hard fault, gonna see its related to RTOS
2018-04-08 ADC only reads once
2018-04-08 Gonna try swapping to DMA
2018-04-08 Updated Project to DMA (gonna do some stuff with rank)
2018-04-08 ADC works now. I hate this
2018-04-08 ADC + TX
2018-04-08 Clearing Flags fixed up the RX problems
    [_Fury_Zero.ioc]
2018-04-09 All 6 ADC Working with RX and TX functioning. No RTOS, but CBF
2018-04-09 Added Various PCB Libraries
    [0204_MELF.PcbLib, 0207_MELF.PcbLib, 0603_C.PcbLib, 0603_L.PcbLib, 0603_R.PcbLib, 0805_C.PcbLib, 0805_C2.PcbLib, 0805_R.PcbLib]
2018-04-09 Took out libraries and added them to a seperate repo
    [0204_MELF.PcbLib, 0207_MELF.PcbLib, 0603_C.PcbLib, 0603_L.PcbLib, 0603_R.PcbLib, 0805_C.PcbLib, 0805_C2.PcbLib, 0805_R.PcbLib]
2018-04-10 Updated GitIgnore
    [PCB_Project.PrjPcb]
2018-04-10 IR Sensor works, turns out they blow really easily
2018-04-16 Going to swap ADC A & B to digital inputs
    [_Fury_Zero.ioc]
2018-04-16 Idk, the sensor works
2018-04-21 Order parts rev A
    [BOM.xlsx]
2018-04-21 Updated BOM to base
    [BOM.xlsx]
2018-05-02 Trying to daisy chain
2018-05-02 Changes to run config, doesn't work after power cycle
2018-05-02 _Infinite_Cobra Seems to be set up, will boot from battery (YAY!)
2018-05-03 ADC is too damn slow and i just spent $70 on pcb variations, fss
2018-05-03 Going back to GPIO inputs (ADC is too god damn slow
2018-05-03 Starting on Messaging Relay
2018-05-04 Daisy Chain Works (YAY)
2018-05-04 4/05/2018 12:34:28 PM
    [BOM.xlsx]
2018-05-05 I'm tired
2018-05-06 Added KKs to BOM
    [BOM.xlsx]
2018-05-06 6/05/2018 5:44:52 PM
    [BOM.xlsx]
2018-05-07 Preliminary PID Parameters
2018-05-16 ADC effecting each other, need op amps
2018-05-17 17/05/2018 6:16:35 PM
    [BOM.xlsx]
2018-05-17 Swapping to timer interupt
2018-05-18 18/05/2018 8:58:25 PM
    [ADC Config.xlsx]
2018-05-18 This is ridiculous, i need to swap back
    [ADC Config.xlsx]
2018-05-18 0.9 PWM
2018-05-18 19/05/2018 9:06:54 AM
    [ADC Config.xlsx]
2018-05-20 Process Flow Diagram
2018-05-23 UART Works
2018-05-24 YM-2765 Servo
    [Progress Bar.xlsx]
2018-05-25 Two Sensors
2018-05-25 ADC A
2018-05-26 4.7 Ohm
2018-05-26 Load Cell Calibration
2018-05-27 27/05/2018 11:06:12 PM
    [Load Cell Calibration.xlsx]
2018-05-28 28/05/2018 1:58:25 PM
    [Progress Bar.xlsx]
2018-05-28 28/05/2018 2:47:19 PM
    [Progress Bar.xlsx]
2018-05-29 Finished Scope
    [Progress Bar.xlsx]
2018-05-29 29/05/2018 7:16:50 PM
    [Progress Bar.xlsx]
2018-05-30 30/05/2018 1:32:50 PM
    [Progress Bar.xlsx]
2018-05-30 30/05/2018 8:54:51 PM
    [Progress Bar.xlsx]
2018-05-30 31/05/2018 8:53:02 AM
    [Progress Bar.xlsx]
2018-05-31 IR Sensor Files
    [Progress Bar.xlsx, Sensor PCB.PcbDoc, Sensor Schematic.SchDoc, Sensor_Mount_Project.PrjPCB]
2018-05-31 31/05/2018 6:27:10 PM
    [Progress Bar.xlsx]
2018-06-01 Time for shopping
    [Progress Bar.xlsx]
2018-06-01 1/06/2018 7:29:42 PM
    [Progress Bar.xlsx]
2018-06-01 Do eq kill it?
    [Progress Bar.xlsx]
2018-06-01 2/06/2018 8:04:52 AM
    [Progress Bar.xlsx]
2018-06-01 2/06/2018 9:27:46 AM
    [Load Cell Calibration.xlsx, Progress Bar.xlsx]
2018-06-02 2/06/2018 11:17:20 AM
    [Progress Bar.xlsx]
2018-06-02 Vector of centrifugal and Coriolis forces
    [Progress Bar.xlsx]
2018-06-02 3/06/2018 8:31:37 AM
    [Progress Bar.xlsx]
2018-06-03 3/06/2018 5:46:42 PM
    [Progress Bar.xlsx]
2018-06-04 PID Explained
2018-06-04 4/06/2018 6:52:35 PM
    [Progress Bar.xlsx]
2018-06-04 LM358AD - Low-Voltage Rail-to-Rail Output Operational Amplifier
    [Progress Bar.xlsx]
2018-06-04 5/06/2018 9:15:51 AM
    [Progress Bar.xlsx]
2018-06-05 6/06/2018 7:34:45 AM
    [Progress Bar.xlsx]
2018-06-05 Morning, cold fingers
2018-06-06 6/06/2018 11:21:13 AM
    [Progress Bar.xlsx]
2018-06-06 Ripping & Tearing
    [Progress Bar.xlsx]
2018-06-06 6/06/2018 4:01:41 PM
    [Progress Bar.xlsx]
2018-06-07 CAD Schematics
    [Attachment_Double.ipt, Attachment_Single.ipt, Cable_Guide.ipt, Lower_Loadcell_Mount.ipt, Mount_Brace.ipt, Mount_Panel.ipt, SMW-43219667-METR4901.idw, SensorMount - B.ipt]
2018-06-07 Added Matlab
    [PID Parameters.xlsx]
2018-06-07 Supporting Documenation
    [Controller_PCB.PcbDoc, Controller_PCB_Base.SchDoc, Controller_PCB_LED.SchDoc, Controller_PCB_OPAMP.SchDoc, Controller_PCB_Project.PrjPCB]
2018-06-08 8/06/2018 10:00:49 AM
    [Progress Bar.xlsx]
2018-06-09 9/06/2018 10:35:10 AM
    [Progress Bar.xlsx]
2018-06-09 9/06/2018 11:05:24 AM
    [Progress Bar.xlsx]
2018-06-09 9/06/2018 11:35:38 AM
    [Progress Bar.xlsx]
2018-06-09 9/06/2018 12:36:02 PM
    [Progress Bar.xlsx]
2018-06-09 10/06/2018 7:05:59 AM
    [Progress Bar.xlsx]
2018-06-10 10/06/2018 12:07:59 PM
    [Progress Bar.xlsx]
2018-06-10 Added Spice Models
    -Fix up equations
    -Take photos
    -Abstract
    -2nd Order PID
2018-06-10 11/06/2018 7:35:09 AM
    [Progress Bar.xlsx]
2018-07-09 9/07/2018 2:58:14 PM
    [Attachment_Double.ipt, Attachment_Single.ipt, Cable_Guide.ipt, Controller_PCB.PcbDoc, Controller_PCB_Base.SchDoc, Controller_PCB_LED.SchDoc, Controller_PCB_OPAMP.SchDoc, Controller_PCB_Project.PrjPCB]
